edi-z/FE3/PCB-Gerber/README.md

Final Expansion FE3 Gerber File for PCB production    
https://www.gerber-viewer.com/ to view the files
