edi-z/FE3/images/Battery_2032_Holder.jpg

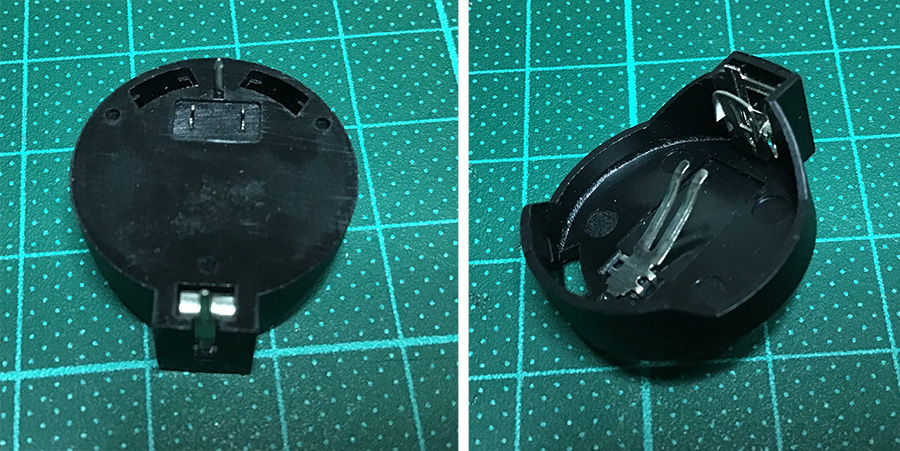
images/Battery_2032_Holder.jpg
