edi-z/FE3/images/FE3_Rev10c_PCB_blank.jpg

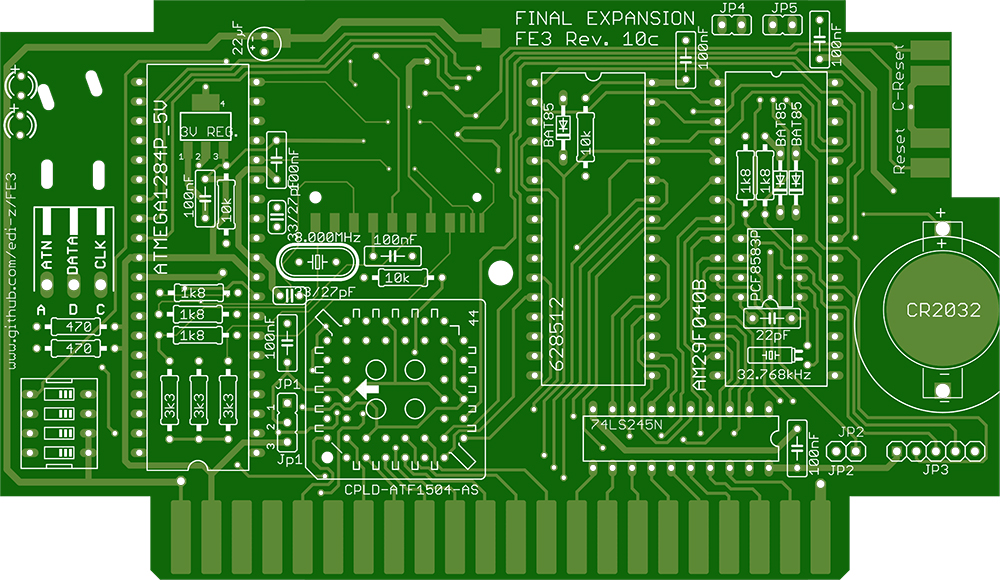
images/FE3_Rev10c_PCB_blank.jpg
