edi-z/FE3/images/SD_Connector.jpg

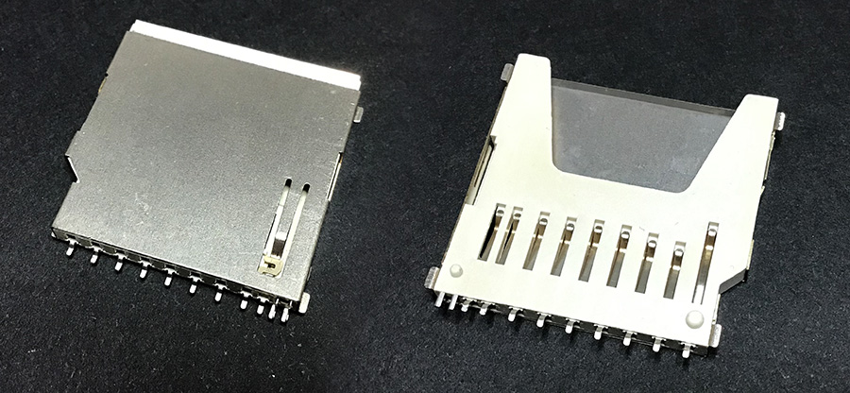
images/SD_Connector.jpg
