edi-z/FE3/images/volt_reg.jpg

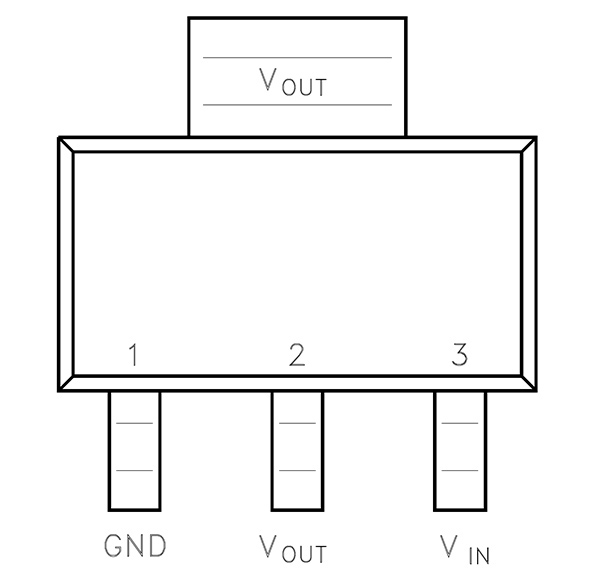
images/volt_reg.jpg
