edi-z/FE3/images/FE3_V3_REV10c.pdf

F

I

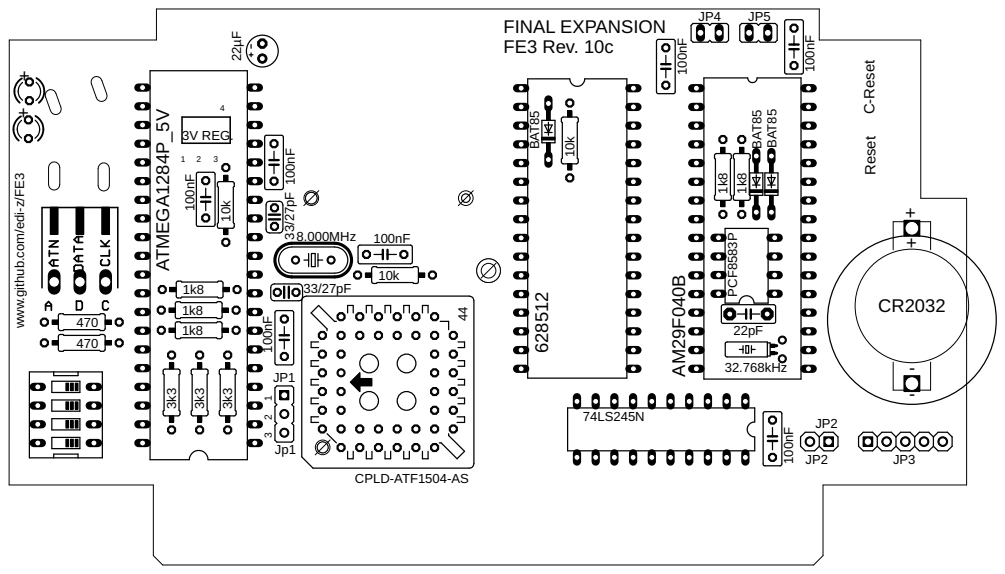
[picture p6: page 1]
C-Reset Reset; ATMEGA1284P; BAT85; PCF8583P

www.github.com/edi-z/FE3
