edi-z/FE3/PCB-Eagle/FE3_V3_REV10c.sch

## EAGLE design PCB-Eagle/FE3_V3_REV10c.sch (2019-09-29)

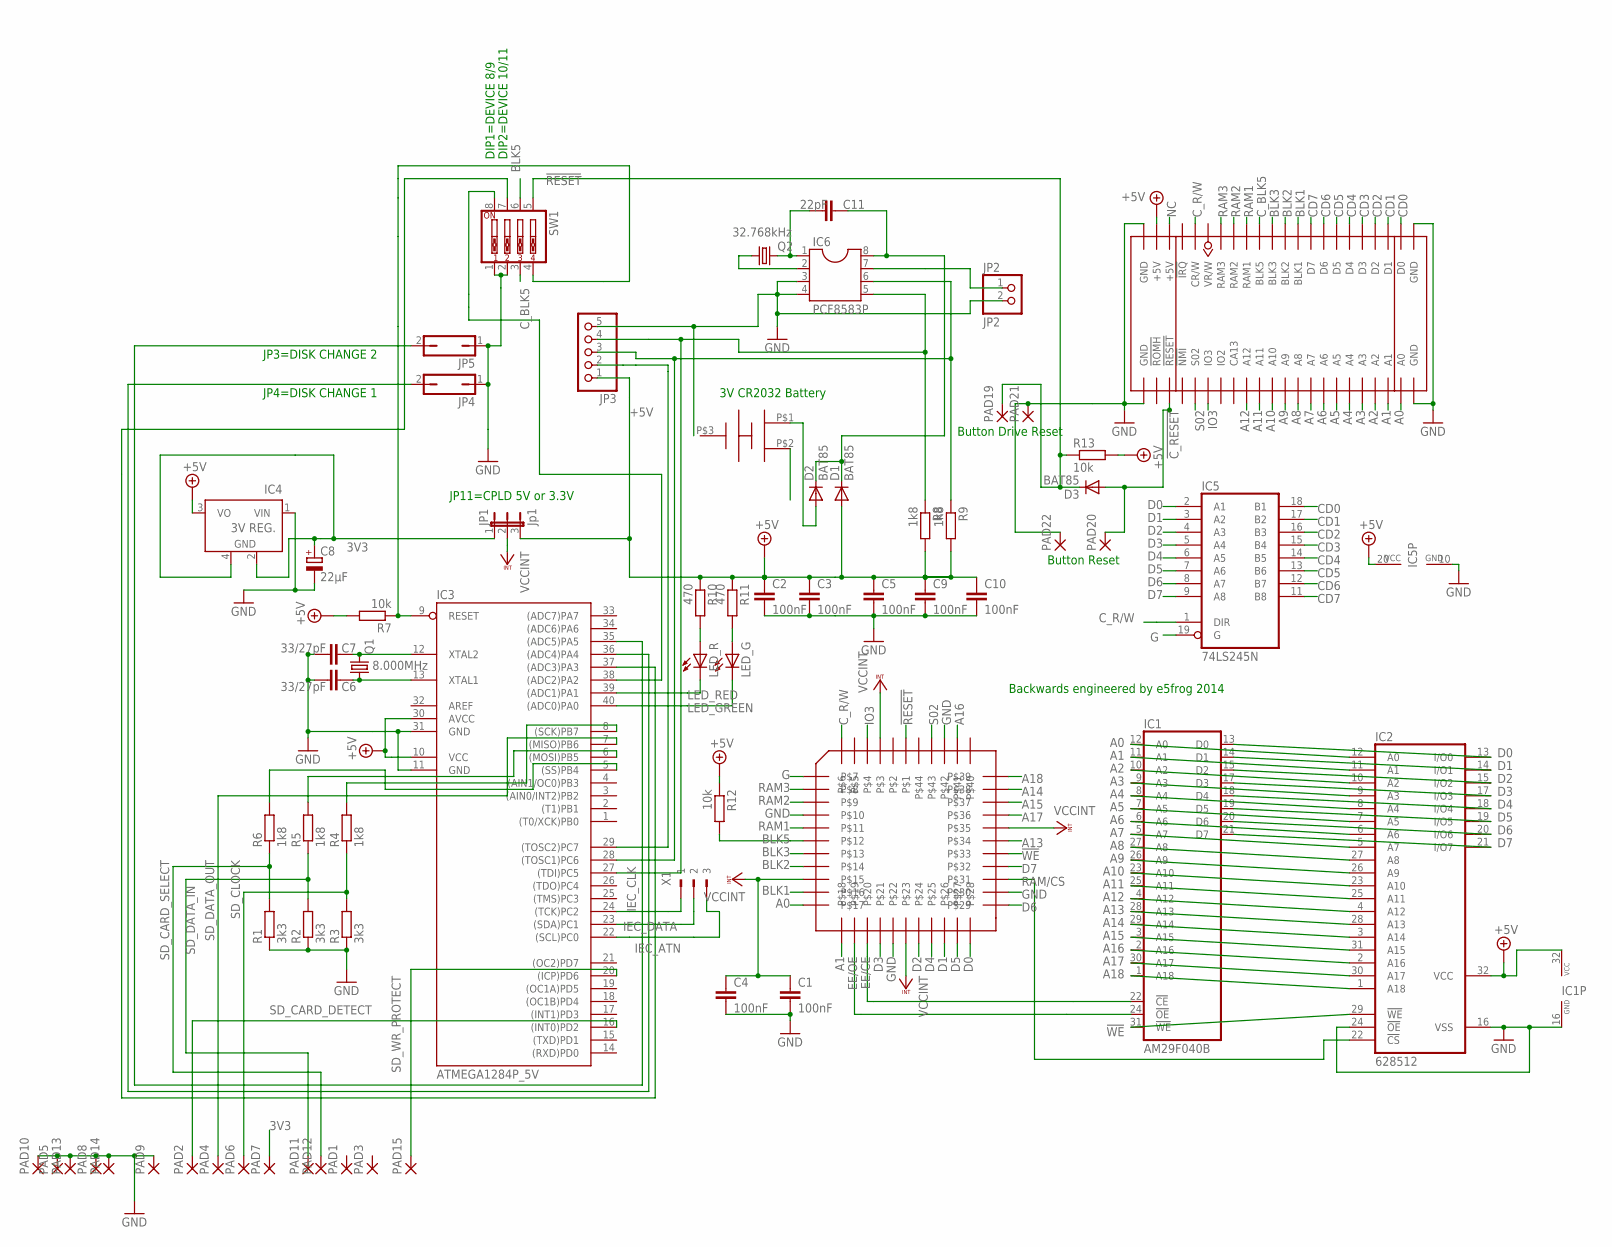
[picture p7: schematic FE3_V3_REV10c.sch]

Parts:
C1, C2, C3, C4, C5, C9, C10: 100nF; C050-025X075
C6, C7: 33/27pF; C025-024X044
C8: 22µF; E2-4
C11: 22pF; C5B2.5
D1, D2, D3: BAT85; DO34-7
IC1: AM29F040B; DIL32
IC2: 628512; DIL32
IC3: ATMEGA1284P_5V; DIL40
IC4: 3V REG.; SOT223
IC5: 74LS245N; DIL20
IC6: PCF8583P; DIL08
JP1: Jp1; JP2_N
JP2: JP2; 1X02
JP3: PINHD-1X5; 1X05
JP4, JP5: JP1Q; JP1
LED_G: LED3MM
LED_R: LED3MM
PAD1, PAD2, PAD15: SMD_EZ1; SMD0,7-254
PAD3, PAD4, PAD5, PAD6, PAD7, PAD8, PAD9, PAD10, PAD11, PAD12, PAD13, PAD14: SMD2; SMD1,27-2,54
PAD19, PAD20, PAD21, PAD22: SMD5; SMD2,54-5,08
Q1: 8.000MHz; HC49U-V
Q2: 32.768kHz; TC26H
R1, R2, R3: 3k3; 0207/10
R4, R5, R6, R8, R9: 1k8; 0207/10
R7, R12, R13: 10k; 0207/10
R10, R11: 470; 0207/10
SW1: SW_DIP-4; EDG-04
U$1: CPLD-ATF1504-AS; S44
U$2: VIC-20_EXPANSION
U$3: CR2032_RETAINER_PK5
X1: 90-3

Connections:
3V3: C8.+, IC4.2 (GND), IC4.4 (GND), JP1.1, PAD7.1
!C_RESET: D3.A, PAD20.1, U$2.P$25 (!RESET)
!RESET: D3.C, PAD19.1, R13.1, SW1.5, U$1.1
!WE: IC1.31 (!WE), IC2.29 (!WE), U$1.33
+5V: C2.1, C3.1, C5.1, C9.1, C10.1, D1.A, IC1.32 (VCC), IC2.32 (VCC), IC3.10 (VCC), IC3.30 (AVCC), IC4.3 (VO), IC5.20 (VCC), JP1.3, JP3.1, R7.2, R8.2, R9.2, R10.1, R11.1, R12.1, R13.2, U$2.P$2 (+5V)
A0: IC1.12 (A0), IC2.12 (A0), U$1.17, U$2.P$43 (A0)
A1: IC1.11 (A1), IC2.11 (A1), U$1.18, U$2.P$42 (A1)
A2: IC1.10 (A2), IC2.10 (A2), U$2.P$41 (A2)
A3: IC1.9 (A3), IC2.9 (A3), U$2.P$40 (A3)
A4: IC1.8 (A4), IC2.8 (A4), U$2.P$39 (A4)
A5: IC1.7 (A5), IC2.7 (A5), U$2.P$38 (A5)
A6: IC1.6 (A6), IC2.6 (A6), U$2.P$37 (A6)
A7: IC1.5 (A7), IC2.5 (A7), U$2.P$36 (A7)
A8: IC1.27 (A8), IC2.27 (A8), U$2.P$35 (A8)
A9: IC1.26 (A9), IC2.26 (A9), U$2.P$34 (A9)
A10: IC1.23 (A10), IC2.23 (A10), U$2.P$33 (A10)
A11: IC1.25 (A11), IC2.25 (A11), U$2.P$32 (A11)
A12: IC1.4 (A12), IC2.4 (A12), U$2.P$31 (A12)
A13: IC1.28 (A13), IC2.28 (A13), U$1.34
A14: IC1.29 (A14), IC2.3 (A14), U$1.38
A15: IC1.3 (A15), IC2.31 (A15), U$1.37
A16: IC1.2 (A16), IC2.2 (A16), U$1.41
A17: IC1.30 (A17), IC2.30 (A17), U$1.36
A18: IC1.1 (A18), IC2.1 (A18), U$1.39
BLK1: U$1.16, U$2.P$13 (BLK1)
BLK2: U$1.14, U$2.P$12 (BLK2)
BLK3: U$1.13, U$2.P$11 (BLK3)
BLK5: R12.2, SW1.6, U$1.12
CD0: IC5.18 (B1), U$2.P$21 (D0)
CD1: IC5.17 (B2), U$2.P$20 (D1)
CD2: IC5.16 (B3), U$2.P$19 (D2)
CD3: IC5.15 (B4), U$2.P$18 (D3)
CD4: IC5.14 (B5), U$2.P$17 (D4)
CD5: IC5.13 (B6), U$2.P$16 (D5)
CD6: IC5.12 (B7), U$2.P$15 (D6)
CD7: IC5.11 (B8), U$2.P$14 (D7)
C_BLK5: SW1.3, U$2.P$10 (BLK5)
C_R/W: IC5.1 (DIR), U$1.6, U$2.P$5 (CR/W)
D0: IC1.13 (D0), IC2.13 (I/O0), IC5.2 (A1), U$1.28
D1: IC1.14 (D1), IC2.14 (I/O1), IC5.3 (A2), U$1.26
D2: IC1.15 (D2), IC2.15 (I/O2), IC5.4 (A3), U$1.24
D3: IC1.17 (D3), IC2.17 (I/O3), IC5.5 (A4), U$1.21
D4: IC1.18 (D4), IC2.18 (I/O4), IC5.6 (A5), U$1.25
D5: IC1.19 (D5), IC2.19 (I/O5), IC5.7 (A6), U$1.27
D6: IC1.20 (D6), IC2.20 (I/O6), IC5.8 (A7), U$1.29
D7: IC1.21 (D7), IC2.21 (I/O7), IC5.9 (A8), U$1.32
EE/CE: IC1.22 (!CE), U$1.20
EE/OE: IC1.24 (!OE), U$1.19
G: IC5.19 (G), U$1.7
GND: C1.2, C2.2, C3.2, C4.2, C5.2, C6.2, C7.2, C8.-, C9.2, C10.2, IC1.16 (GND), IC2.16 (VSS), IC2.24 (!OE), IC3.11 (GND), IC3.31 (GND), IC4.1 (VIN), IC5.10 (GND), IC6.3, IC6.4, JP2.2, JP3.5, JP4.1, JP5.1, PAD5.1, PAD8.1, PAD9.1, PAD10.1, PAD13.1, PAD14.1, PAD21.1, PAD22.1, R1.1, R2.1, R3.1, SW1.1, SW1.2, U$1.10, U$1.22, U$1.30, U$1.42, U$2.P$1 (GND), U$2.P$22 (GND), U$2.P$23 (GND), U$2.P$44 (GND), U$3.P$2
IEC_ATN: IC3.22 ((SCL)PC0), X1.3
IEC_CLK: IC3.24 ((TCK)PC2), X1.1
IEC_DATA: IC3.23 ((SDA)PC1), X1.2
IO3: U$1.4, U$2.P$28 (IO3)
LED_GREEN: IC3.40 ((ADC0)PA0), LED_G.K (C)
LED_RED: IC3.39 ((ADC1)PA1), LED_R.K (C)
unnamed: IC3.37 ((ADC3)PA3), SW1.7
unnamed: IC3.36 ((ADC4)PA4), JP4.2
unnamed: IC3.35 ((ADC5)PA5), JP5.2
unnamed: LED_R.A, R10.2
unnamed: IC3.38 ((ADC2)PA2), SW1.8
unnamed: IC3.29 ((TOSC2)PC7), JP3.2
unnamed: LED_G.A, R11.2
unnamed: IC3.27 ((TDI)PC5), IC6.5, JP3.4, R8.1
unnamed: IC3.8 ((SCK)PB7), R4.2
unnamed: IC3.6 ((MOSI)PB5), R5.2
unnamed: IC3.5 ((SS)PB4), R6.2
unnamed: IC3.9 (RESET), R7.1, SW1.4
unnamed: D2.A, U$3.P$1
unnamed: C7.1, IC3.12 (XTAL2), Q1.2
unnamed: C6.1, IC3.13 (XTAL1), Q1.1
unnamed: C11.1, D1.C, D2.C, IC6.8
unnamed: C11.2, IC6.1, Q2.2
unnamed: IC6.2, Q2.1
unnamed: IC6.7, JP2.1
unnamed: IC3.28 ((TOSC1)PC6), IC6.6, JP3.3, R9.1
NC: U$2.P$3 (+5V)
RAM1: U$1.11, U$2.P$9 (RAM1)
RAM2: U$1.9, U$2.P$8 (RAM2)
RAM3: U$1.8, U$2.P$7 (RAM3)
RAM/CS: IC2.22 (!CS), U$1.31
S02: U$1.43, U$2.P$27 (S02)
SD_CARD_DETECT: IC3.16 ((INT0)PD2), PAD2.1
SD_CARD_SELECT: PAD12.1, R1.2, R6.1
SD_CLOCK: PAD6.1, R3.2, R4.1
SD_DATA_IN: PAD11.1, R2.2, R5.1
SD_DATA_OUT: IC3.7 ((MISO)PB6), PAD4.1
SD_WR_PROTECT: IC3.20 ((ICP)PD6), PAD15.1
VCCINT: C1.1, C4.1, JP1.2, U$1.3, U$1.15, U$1.23, U$1.35

Notes on the sheet:
3V CR2032 Battery
JP11=CPLD 5V or 3.3V
JP3=DISK CHANGE 2
JP4=DISK CHANGE 1
DIP2=DEVICE 10/11
DIP1=DEVICE 8/9
Button Drive Reset
Button Reset
Backwards engineered by e5frog 2014
